sinara-hw/Driver/README.md

# Driver
Semiconductor diode laser current driver

* [RFC](https://github.com/sinara-hw/Driver/issues/1)
* [Wiki](https://github.com/sinara-hw/Driver/wiki)
