sinara-hw/Driver/(list of files, drawings)

Other design files:
AFE_conn.SchDoc
AI_ARTIQ_Driver.SchDoc
connectors.SchDoc
DAC.SchDoc
Diagnostics.SchDoc
FOLLOWER_DIVIDER.SchDoc
HP_LASER_PS.SchDoc
I2C.SchDoc
ISOLATED_PS.SchDoc
LASER_DRIVER_LN_HP.PrjPcb
LN_LASER_PS.SchDoc
output_stage.SchDoc
