sinara-hw/Driver/(threads)

Thread 1 (2019-12-29):

[RFC] Driver: current driver for laser diodes

jordens, 2019-12-29:
We may be looking at designing a diode laser current driver in the future. Comments and secondments welcome.

### General notes

* Low-noise current controller for (low-power) laser diodes.
* Form factor TBD. May end up being a Stabilizer mezzanine or a separate board that interfaces with Stabilizer or a separate EEM
* Either two versions for 200-250mA and 1.5-2A range or variants or one design that fits both
* Different from the [coil current driver](https://github.com/sinara-hw/meta/issues/23) in that it has smaller range, drives diode-like loads, doesn't need that much stability, but needs modulation features.
* Linkage to Thermostat: ethernet, Stabilizer: analog, and Zapper: analog
* Specifications and performance goals similar to the open designs:
  * [Libbrecht-Hall](https://aip.scitation.org/doi/10.1063/1.1143949)
  * [Libbrecht-Hall-Durfree](https://arxiv.org/pdf/0805.0015)
  * [Libbrecht-Hall-Seck](https://arxiv.org/pdf/1604.00374)
  * [JQI](https://github.com/jqiamo/current-controller/tree/v2-updates) to be consolidated, based on Libbrecht-Hall-Durfree
* Compare to proprietary things:
  * [Vescent](https://www.vescent.com/products/electronics/d2-105-laser-controller/)
  * [ILX Lightwave](https://www.newport.com/f/precision-laser-diode-drivers-ldx-3200)
  * [Toptica](https://www.toptica.com/products/tunable-diode-lasers/laser-driving-electronics/)
  * [Koheron](https://www.koheron.com/): uses LT3045, LT3261, OPA567, LT6655
  * [MOGLabs](http://www.moglabs.com/diode-laser-controller.html)
  * [SISYPH SMC11](http://www.sisyph.com/smc11-puy-mary-ultra-low-noise-current-source)

### Variant A

  * 250 mA
  * 2V compliance
  * single quadrant
  * assumptions/requirements w.r.t cathode grounded, anode grounded TBD
  * 0.5 µA resolution, digitally controlled (~100 kHz resolution, 200MHz/mA tuning)
  * 10 kHz small signal bandwidth
  * RMS noise 10Hz-10MHz: 0.3 µA
  * RMS noise 10Hz-10kHz: 0.05 µA
  * Stability (<10Hz) TBD
  * Linearity/absolute accuracy: 2% TBC
  * tempco 5 µA/K (1 MHz/K, 20 ppm/K) TBC
  * high demands on laser diode safety guarantees: no turn on/off transients, no chance of ESD/ground potential difference getting through to the diode, benign behavior and recovery from short circuits and open connections
  * could be some coarse+fine additive or multiplicative hybrid solution to achieve resolution TBD
  * has a modulation/error signal input that is both sampled by an ADC (at 100 kHz) and a high frequency bypass (10 kHz to 100 MHz) that goes onto a bias tee (together with the low frequency current output from the controller) on the output to the laser. Or alternative approaches TBD.

### Variant B (otherwise same as A)
  * 1.5A
  * 3 V compliance
  * bandwidth and resolution much less critical
  * noise requirement at a similar relative level as A

jordens, 2020-01-14:
Added the [AOSense](https://aosense.com/solutions/integrated-laser-controller/) module to the top post. Thanks Mariusz for pointing it out.

dtcallcock, 2020-03-01:
Is there any reason to think Variant B wouldn't also make a nice current supply for the few-Gauss field coils found on most ion traps (or at least a good starting point for one - a factor of 2 more current might be nice)?  Is it funded or was that just the A Variant?

jordens, 2020-03-01:
You'd have to deal with the inductive load. Both variants are funded.
But for shim coils it looks like overkill: around 10 A-turns you can dimension the coil to be in the range of a simple single-opamp voltage-to-current converter running of Zotino/Fastino since there are no grounding restrictions. This would also be bipolar while Driver will not necessarily be.

fimek, 2021-02-08:
Right now there are following problems regarding laser driver:
- combining the expected noise level with reasonable power consumption,
- laser driver precision (meeting the 16-bit DAC precision and resolution),
- bipolar transistors instead of unipolar transistors (due to their more promising noise parameter),
- DAC noise density within 100 kHz bandwidth (seems to be the most challenging - the DAC cannot be BW limited for noise reduction).

It should be decided whether it is sensible to test just the unidirectional current source, or the current source sould be designed as bidirectional (compatible with both common anode and common cathode lasers).

fimek, 2021-02-08:
My strategy briefly explained:
1. DAC: non buffered DAC, where the only output noise is the one generated by the R-2R ladder. Best achievable parameters: 7...9 nV/sqrt(Hz). Proposed ICs: DACx1001, AD5791 (seems similar in performance).
2. DAC output voltage swing: maximum available: 0...10V. If the reference voltage for the current source is too high - can be divided leading to DAC output noise reduction. 0...10V will match the current source optimum driving voltage.....
3. ....which depends on the output transistor emiter resistance. 40 Ohms seems OK, together with ref. voltage of up to 10 V result in 250 mA of maximum laser current.
4. Current source has to be built around the opamp with En <= 3nV/sqrt(Hz), low input current noise (together with DAC ladder resistance would degrade noise performance) <= 0.5 pA/sqrt(Hz), low bias current and appropriate  input voltage offset. Fortunately - such opamps exist: AD8675.
5. By using the additional JFET we can get rid of output transistor base current and maintain DC stability.
6. Power supply: +15V /- 5V (can be +15V/-15 V either).
7. It's a bit tricky to generate a current source with grounded anode/cathode, because the reference voltage for the current source must be referred to Vdd or Vss. I'd rather avoid differential amplifiers (due to remarkable additional noise contribution). I' would use LTC1043 (or similar) instead (the BW is sufficient).
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

Thread 2 (2022-03-21):

Voltage sense

jordens, 2022-03-21:
An independent (from the current driven) measurement of the voltage drop across the diode at the header board ("4-wire") would be very useful.

gkasprow, 2022-03-21:
We have enough analog inputs on the photodiode ADC to do so.

Thread 3 (2022-04-04):

Driver module schematics review

akaminska, 2022-04-04:
Please find attached the preliminary Driver schematics for review. Please note:

- This project is focused on the low-noise current source. The higher power current source is still under design and will be added later.
- The laser protection subsystem ("protection", schematics on the last page of the attached pdf) will be updated, please omit it for now in your review.
[driver_3_en_16032022.pdf](https://github.com/sinara-hw/Driver/files/8410830/driver_3_en_16032022.pdf)

filipswit, 2022-05-18:
PDF version of schematics:
[AI-ARTIQ Driver v0.2.pdf](https://github.com/sinara-hw/Driver/files/8715866/AI-ARTIQ.Driver.v0.2.pdf)

nkrackow, 2022-05-20:
I might have found an issue:
The `TEMP` node is connected to `T11` base for both driver output protection circuits, right? Let's say there is no over-temperature event, so the temperature sensor open drain output can be ignored. Now if the `IC27` flipflop is set for one side, it will drive both `T11` transistors in both output stages in parallel. Or am I missing something?

I know the protection circuit will go to the headboard but the same applies there.

nkrackow, 2022-05-20:
I also did some lengthy staring at the floating DAC ground setup again and while it's still very confusing I convinced myself that this might work..

Also the rest of the relay logic looks good I think. Just that we need to load new outputs into the shift register twice to change the state of K0 with the flipflop. Can't we use a d-latch eg. [this](https://www.ti.com/lit/ds/symlink/sn74lvc1g373.pdf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)? That would also save all of the nand gates since we can just use the inverted state of the node that now goes from K1 to the first nand gate as the enable signal of the latch.

Last thing is that I remember @jordens wanted to maybe sample the voltage over the output current shunt resistor (the one that gives feedback to the opamp). Is that still relevant?

jordens, 2022-05-21:
* The circuitry on protection.SchDoc and I2C_EXPANDER should be on the header board.
* Can we unify CS_OUT_MON and V_LASER_MON? They both appear to have the same functionality (measuring voltage across the load). I don't see the point in having two. Maybe RL2B to switch the measurement channel (Pin 3) between R130 (Pin 2) and the laser (VLASER J2 Pin 1).
* It would be reaslly desirable to get laser diode current monitoring. Maybe we can rejigger the relay circuitry on the header board to achieve that (use a ~1 Ohm shunt for R130 and put that always in series with the sink/source, independent of whether the laser diode is shorted/bypassed). Or other ideas.
* @nkrackow please also thoroughly review the SPI bus usage and assignment w.r.t. how their STM32 peripherals would be used and whether there are interdependencies and constraints.
* The HP source/sink doesn't need to dissipate that much power. It doesn't need to be so low noise. A 0.1 R or even lower shunt should be fine. Also lower supply voltage (to reduce the drop across the power transistor).
* Can we also add NTCs and some simple circuitry to monitor the heatsink temperature using the CPU ADCs?
* How fast is the current sink/source (including all the output circuitry) to the laser diode.
* Can we make use of Stabilizer's ADCs/DACs (J6)? I think one ADC is used for the LF error signal sampling (is that done via SMA separately from the header board?) But there is one more ADC and two DACs. If the current source isn't very fast it may make sense to have at least a way to couple the DACs AC onto the sink/source currents with C jumpers. Just as a DNP option.

jordens, 2022-05-24:
@schiemangk  @j-hirsch you also wanted to have a look.

gkasprow, 2022-05-31:
I moved the protection schematics to the laser module.
I also used an 8k HDMI cable which has individually shielded pairs to transfer all signals from the laser driver to the laser module.
Here are the schematics:
[Laser module PCB.PDF](https://github.com/sinara-hw/Driver/files/8807392/Laser.module.PCB.PDF)
[Frequency REF module PCB.PDF](https://github.com/sinara-hw/Driver/files/8807396/Frequency.REF.module.PCB.PDF)
[Micro_DSUB_IDC.PDF](https://github.com/sinara-hw/Driver/files/8807407/Micro_DSUB_IDC.PDF)

bbradzik, 2022-06-01:
> I might have found an issue: The `TEMP` node is connected to `T11` base for both driver output protection circuits, right? Let's say there is no over-temperature event, so the temperature sensor open drain output can be ignored. Now if the `IC27` flipflop is set for one side, it will drive both `T11` transistors in both output stages in parallel. Or am I missing something?
>
> I know the protection circuit will go to the headboard but the same applies there.

Good point. We will add components to isolate both (LN and HP) TEMP nodes.

bbradzik, 2022-06-01:
> Also the rest of the relay logic looks good I think. Just that we need to load new outputs into the shift register twice to change the state of K0 with the flipflop. Can't we use a d-latch eg. [this](https://www.ti.com/lit/ds/symlink/sn74lvc1g373.pdf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)? That would also save all of the nand gates since we can just use the inverted state of the node that now goes from K1 to the first nand gate as the enable signal of the latch.

About month ago I draw similar circuit with level triggered D flip flop. Greg has told me to swap it with edge triggered D flip flop commenting (as far as i recall) that it will be more proof against unwanted enabling of the laser.

> Last thing is that I remember @jordens wanted to maybe sample the voltage over the output current shunt resistor (the one that gives feedback to the opamp). Is that still relevant?

The idea is good, however it would require to add two instrumentation amplifiers.
Would four voltage measuring points (two per laser diode) be still relevant then?

nkrackow, 2022-06-01:
> About month ago I draw similar circuit with level triggered D flip flop. Greg has told me to swap it with edge triggered D flip flop commenting (as far as i recall) that it will be more proof against unwanted enabling of the laser.

I see, then we'll just do some more flipping and flopping with the CPU via I2C. :)

> The idea is good, however it would require to add two instrumentation amplifiers.
Would four voltage measuring points (two per laser diode) be still relevant then?

Yeah I think this would be on the wishlist from QUARTIQ side. As stated in my response to Roberts points, we could just have the four signals going back to the Stabilizer MCU ADCs (`JADCx_INx_x` on the Stabilizer header, we don't need differential there) via the 8K HDMI cable. I think there should be some lanes available still @gkasprow?

nkrackow, 2022-07-13:
Hi, one more thing that just came up on our side is that the software needs to detect if Driver is present on Stabilizer. A nice way to do this would be to read an EEPROM via the I2C line that goes to Driver anyways. Would be great if we could still tag that onto the prototype.

nkrackow, 2022-07-20:
Ok, one last last thing is that it could be nice to have the global overtemperature node `TEMP` also available on an MCU GPIO if we can fit it somehow.
Sorry, I'll stop adding things here as soon as someone tells me Driver is finalized. ;)

Closed 2022-09-22.

Thread 4 (2022-08-01):

min DP cables

gkasprow, 2022-08-01:
Note to myself and users: mini DP cables have source and sink sides.  Wiki says:
This is the pinout for the source-side connector; the sink-side connector pinout will have lanes 0–3 reversed in order, i.e. lane 3 will be on pin 3(n) and 5(p) while lane 0 will be on pin 10(n) and 12(p).

Thread 5 (2022-08-10):

PDF version

nkrackow, 2022-08-10:
Hi, could we also get a PDF version of the schematic+layout if that's not too much of a hassle?

filipswit, 2022-08-10:
Sorry, I forgot about PDFs
Schematics are in sink variant just to know which other components will be mounted
[AI-ARTIQ Driver v1.0_sch LNsiHPsi.pdf](https://github.com/sinara-hw/Driver/files/9299079/AI-ARTIQ.Driver.v1.0_sch.LNsiHPsi.pdf)
[AI-ARTIQ Driver v1.0_pcb print.pdf](https://github.com/sinara-hw/Driver/files/9299018/AI-ARTIQ.Driver.v1.0_pcb.print.pdf)
[AI-ARTIQ Driver v1.0_3D pcb print.pdf](https://github.com/sinara-hw/Driver/files/9299019/AI-ARTIQ.Driver.v1.0_3D.pcb.print.pdf)

filipswit, 2022-09-19:
[AI-ARTIQ Driver v1.0rc1_sch LNsiHPsi.pdf](https://github.com/sinara-hw/Driver/files/9596875/AI-ARTIQ.Driver.v1.0rc1_sch.LNsiHPsi.pdf)

filipswit, 2022-09-22:
Actual PDFs are in release.

Closed 2022-09-22.

Thread 6 (2022-08-10):

Driver schematic/layout review

nkrackow, 2022-08-10:
We've had a good look at the layout now and it looks very nice! We're of course no experts in layout so we didn't check for clearance or trace thickness or things like that.
Just a few comments about the layout:
- ~~Did you check the assembly with Stabilizer? Aka that there are no tall components potentially colliding with Stabilizers components?~~ Just saw in 3D view of the Altium Viewer that Stabilizer is there, so obviously yes.
- Are the right nodes on the HDMI pins that make connection first? ~~The TEMP node should make connection first when plugging in and break last when pulling out.~~ Edit: The TEMP node should make connection _last_ when plugging in and break _first_ when pulling out.

There are two points from the schematic review still:
- https://github.com/sinara-hw/Driver/issues/3#issuecomment-1190233600 We would really like to also have control over the TEMP node from the CPU. The best would be if the TEMP node is usually pulled low (aka overwriting the relay logic and forcing the laser diode to be shorted) until a CPU pin goes high.
- https://github.com/sinara-hw/Driver/issues/3#issuecomment-1143563047 We would like to measure the voltage across the output shunt resistor to continuously be able to measure the output current.

jordens, 2022-08-10:
> The TEMP node should make connection first when plugging in and break last when pulling out.

The other way round.

filipswit, 2022-08-12:
> https://github.com/sinara-hw/Driver/issues/3#issuecomment-1190233600 We would really like to also have control over the TEMP node from the CPU. The best would be if the TEMP node is usually pulled low (aka overwriting the relay logic and forcing the laser diode to be shorted) until a CPU pin goes high.

So on Driver module, I could use `LPTIM2_OUT`, it's not used so far. Is it fine to just short `TEMP `and `LPTIM2_OUT`?

nkrackow, 2022-08-15:
We would suggest the following solution:

Since we need some kind of decoupling from the transistor bases anyways (https://github.com/sinara-hw/Laser_Module/issues/1), `TEMP` becomes a logic signal that is valid either high or low.
Then we can have a big pulldown resistor (~10K) on `TEMP` the header board that usually makes sure that `K1` cannot be enabled (maybe we don't even need that with npn transistors since nothing is actively driving the node).
The MCU GPIO pin is then connected to `TEMP` via a small resistor (~100 ohm / whatever fits with the base current limiting resistors) and can therefore drive `TEMP` high, making it possible to activate `K1` via the other relay logic.
The LM75 can then still force `TEMP` low.

We could even call this an interlock at this point, but we're fine with naming it `TEMP`, too.

filipswit, 2022-09-19:
The final version is already on repo. I've splitted TEMP and MCU_Interlock, so we have two signals which should be compared on Laser_Module board. I've places them on pins 13 and 19, We can't use  1st pin because it's wired as diff pair so we'd lose it.

jordens, 2022-09-20:
@filipswit Great work. Thanks for the release! Let's hope and push that this gets manufactured in time.
Could you check the issues and either close them when there is nothing to be done or ping the respective people if unresolved and waiting for input?

gkasprow, 2022-09-20:
@filipswit please update the connector as we discussed. I implemented changes on my side
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

filipswit, 2022-09-21:
Updated pinout in https://github.com/sinara-hw/Driver/commit/d203db5ae0c88f6e30ad801b221f2400497f251d

Closed 2022-09-21.

Thread 7 (2022-11-28):

SPI MISO pin driven by both optical isolators concurrently

nkrackow, 2022-11-28:
The SPI MISO pin on the "normal" ground side is actively driven `low`/`high` by both HCPL-092J optical isolators at the same time.
I see good signals (>4.5 V `high`) on the isolated side coming from the DAC but only about 0.5 V `high` signal level on the "normal" GND side. Signals going to the DAC look good too and it's obviously trying to answer.
I'm pretty sure this is because the other isolator chip tries to keep this node low since its isolated side is low because the other DAC isn't selected and therefore it's MISO is low.
I can also see significant ripple with similar frequency content to the SPI traffic on the isolator chip power, which could mean that it's pumping a lot of current.

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

bbradzik, 2022-12-09:
Suggested temporary solution: lift pin 6 of the IC10B.

Thread 8 (2022-12-08):

Floating high power supply 0 V output

nkrackow, 2022-12-08:
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
The way the resistors can be mounted for HP source the `NEG_HP` output is floating. Same for `POS_HP` for a sink. Therefore we have no power on the HP output. Just shorting `R77`/`R73` (or removing them for the next rev) should fix the issue.

Thread 10 (2022-12-09):

(inconclusive) LN DAC reference voltage not stable

nkrackow, 2022-12-09:
The reference voltages of the DAC on the low noise (LN) side seem to be off under some circumstances. Note that all voltages are with respect to DACGND.
If I just power up Driver and don't connect it's output I see +4.1,-5.0 V. The DAC output is also not at the correct value of -5 V, but at around -0.9 V.
If I short the output, I actually see the expected 250 mA (0x00 DAC reset code) on the output and the reference voltages seem to come closer to nominal +- 5 V (actual value: ~4.95, -4.98). The DAC output is now as expected at -5 V aka at the negative reference.
If I set close to 0 output current (max DAC code), I also see relatively good references (~4.95, -4.98) and the expected DAC output of ~4.95 V. The output current is close to 0.

However in the middle, when the DAC outputs ~0 V, the positive reference seems to be off again, showing about 4.8 V.
Note: The HP side reference voltages (with or without R77 shorted) are always very close to ideal at ~ +4.995,-4.995 V.
I didn't yet understand why the reference voltage is off in the middle of the DAC output range and better (also not ideal) at the extremes. Maybe a grounding issue with the DACGND? We couldn't see a problem with it right away but we very well might have missed something.

nkrackow, 2022-12-14:
The HP side references are rock solid under all possible combinations of the following:
- open output
- shorted output
- high output set current
- near-zero output set current
- some other set current

bbradzik, 2022-12-14:
I'm working on communicating with DAC over SPI the crude way (Arduino) to be able to set different codes and reproduce Your problem. I should have some info in few days.

bbradzik, 2022-12-21:
OK, i have SPI working.
For the LN driver I set three values of current: zero, half scale, full scale. Each setting stays for 3s and cycle.
Without load (loaded with 1 ohm) i get RefP5 of 4.999V RefN5 of -4.998V maybe changing by some 1mV while changing codes. DAC output also is close to -5V; 0V; +5V as expected.
Without load (output open) i get RefP5 of 4.999V RefN5 of -4.998V but DAC output is now changing: +4.98V: -0.43V; +2.04V plus IC15B is hot. So probably input diodes of the opamp are conducting and loading the ouptut of the DAC. Nevertheless open output is not a normal condition for a current source.

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

*All voltages measured wrt DACGND.

nkrackow, 2022-12-26:
Yes, I have also noticed that the opamp gets hot when the output is open. Even though it's not the standard operating condition and seems to not brak anything I'd say that's not optimal.

Summing up our voltage readings:
- We see the same voltages/conditions with an open output.
- Wit a loaded output (I simply shorted it) there is a slight difference: I still see slight shifts in the DAC reference voltages of a few 10s of mV while yours is stable to within 1 mV.

I'll check tomorrow how my reference looks like when I connect a small resistor.

nkrackow, 2022-12-28:
I have checked again with two diodes (0.9 - 1.4V drop depending on current) across the output now and this didn't improve things for me. The negative reference is still rock solid but the positive is at:
- 4.935V for close to 0 A aka DAC output close to positive ref.
- 4.830V for 100 mA current aka close to 0V DAC output aka midpoint between pos. and neg. ref.
- 4.875V for 200 mA current aka ~ -3V DAC output

Thread 11 (2022-12-09):

no HP output current HP due to untightened transistor terminals

nkrackow, 2022-12-09:
After shorting R77 according to https://github.com/sinara-hw/Driver/issues/8 I see good rails for the HP output stage.
The DAC also seems to behave as expected under all observed circumstances (output shorted/open, different DAC output setpoints). Unfortunately I never see any current on the output, no matter what current I set. After the follower-divider stage (the purpose of which is not entirely clear to me) I see a small voltage wrt. the positive 9 V rail, but the output opamp (IC15A) is not happy, aka there is a voltage drop across its inputs.
I didn't get any further so far.

bbradzik, 2022-12-14:
_> the follower-divider stage (the purpose of which is not entirely clear to me)_
The important issue with higher current linear current sources is power dissipation. Especially in the sensing resistor. The power is dissipated also in the power transistor and the load but the sensing resistor is a component which determines how stable the output current will be. That is why we don't want to dissipate a lot of heat in it. Considering P=I^2*R we want the resistance to be small. So the voltage across the resistor  will be low. Wee need to create this low voltage for the current source input. This is what the divider is used. We can't just use out 10V from the DAC. We also don't want to load the DAC's ouptut resistive ladder with the resistive divider because we will loose linearity. So the follower is used to prevent DAC's output from being loaded.

jordens, 2022-12-14:
How does this work out quantitatively? The transconductance of the output stage (including its opamp) is 1/R (the resistance of the shunt). The shunt is 0.68 Ohm, the follower has a gain of about 1/40. Hence the overall transconducance is 0.36 A/V and for 10 V max DAC output max output current is 3.6 A. Is that correct?

bbradzik, 2022-12-14:
Very close.
10V*1/41=0.244V
Across 0.068 ohm resistor this gives 3.58A max.

However there is inconsistency: 0.68R resistor value is printed on the schematics while ordered and soldered is 0.067R.
Now the problem with 0.068R is that the lead/wire/contact resistance is comparable.

The initial components were 0.68R and five 10k resistors in the divider (2V full scale output) but at some point it was changed and overlooked.

jordens, 2022-12-14:
Ah. Thanks for clarifying. Let's update schematics then.

bbradzik, 2022-12-14:
Unfortunately some more issues are in the HP driver.
1. both drivers start with the full current after powering up, creating high inrush current. This off course is mostly due to HP driver
2. the power transistor of the HP driver works too close to the envelope of the Safe Operating Area. The effect is more serious when the driver's output is shorted to ground. After connecting laser diode it is getting better. There are two solutions to that: use bigger transistors  (eg. TIP125) or re-calculate the divider so it gives 2.5A max.

SOA chart for presently used transistor is below:
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

jordens, 2022-12-14:
For AI-ARTIQ this isn't a problem yet, as current hasn't been more than 1A.
Stability is also not such a big issue: in steady-state the resistor heating will only lead to a departure from linearity.

nkrackow, 2022-12-14:
The problem was simply that the base and emitter connections of the output transistor were not connected. The leads were just free in the terminals with the screws wide open. Only the collector lead was tightened. Same was true for the LN side but there it happened to make contact without tightening for me. This was the state we received the boards in.

nkrackow, 2022-12-14:
> 10V*1/41=0.244V
Across 0.068 ohm resistor this gives 3.58A max.

The actual current is relatively consistent with this, just about 5% low. This makes sense when taking parasitic resistances of the terminals etc. into account. Those would be an extra 3.5 mΩ then.

bbradzik, 2022-12-14:
> The actual current is relatively consistent with this, just about 5% low. This makes sense when taking parasitic resistances of the terminals etc. into account. Those would be an extra 3.5 mΩ then.
Seems legit.

I'm glad that You found the error. It would be difficult to observe same behaviour on my board.

nkrackow, 2023-06-29:
closing since this was a specific issue with the first Driver

Closed 2023-06-29.

Thread 12 (2022-12-21):

found PCB bugs and errors

bbradzik, 2022-12-21:
1. swapped U_LN and U_HP text on top layer
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

bbradzik, 2022-12-21:
T14A (top) and T14B (bottom) have swapped D and S pins. The error is on the schematics and PCB. A solution is to desolder both transistors (with ESD precautions), flip it and solder on the back (pin 1 stays where it was, pin 2 should be connected to pin 3 of the footprint )

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

nkrackow, 2022-12-28:
Swapping the pins worked nicely for me. The LN side gives relatively accurate current readings now. Unfortunately the scale factor for the HP side is rather impractical and errors in resistance and other factors lead to significant inaccuracy. I'll open a new issue for this.

Thread 13 (2022-12-29):

High Power current sense

nkrackow, 2022-12-29:
The high power side current sense setup is not very accurate because of the combination of the very small current sense resistor (0.068 Ω) and the small translation scale in the opamp. (Using [this](https://github.com/sinara-hw/Driver/issues/12#issuecomment-1362180968) fix)
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
Only a very small part of the ADC range is utilized and the readings are pretty noisy .There is also an offset of about 0.2 A.
The voltage readings of both sides are also somewhat noisy. The following gives a rough idea of the offsets/noise for voltage and current readings:
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
There are current jumps from 0 to 0.2/2.0 A for LN/HP outputs on the left/right over a diode.

bbradzik, 2023-01-04:
Here is a simplified schematic of the present situation in the HP part and the proposed modifications. The four wire Kelvin sensing won't be needed in proposed solution. Please let me know what You think and I will ask Ania to organize parts for me to test it and for You to modify Yours.
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

nkrackow, 2023-02-13:
Hi @bbradzik, sorry for the late reply.
The changes to the sense part look sensible to me. Looking at the current setup it seems like we could also just change the 10K resistor to ~200ohm for now to make better use of the ADC range?
I don't know what the changes in rail and opamp offset voltages entail, so I can't comment on that.

jordens, 2023-02-24:
Would INA194 be a more robust accurate solution for the high side current sense?

Thread 14 (2023-02-16):

Maximum current output when power cycling Driver!

nkrackow, 2023-02-16:
I know we have already noticed this in other contexts but I think this is a potentially a big hazard in the current revision so I'll open this as an extra issue here:
When connecting Driver to power it will try output the maximum current on both LN and HP outputs! After the MCU started up and the DAC initialization code ran, the outputs are set to minimum output current. But for at least a few milliseconds its max output current.
Another nuisance is that a current limiting bench power supply will usually clamp the current and prevent startup since Driver also draws a lot of power during this phase if it can dump the current on its outputs.

Thread 15 (2023-02-16):

Noise/ripple on the Stabilizer MCU ADC inputs

nkrackow, 2023-02-16:
I was wondering why the readings on the current and voltage readbacks are relatively noisy:
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
This is clear for the HP current channel #13, but the voltage readings should be using quite some dynamic range of the ADC.
I first suspected the software/ADC setup procedure since we had problems with this in the past https://github.com/quartiq/stabilizer/issues/571 https://github.com/stm32-rs/stm32h7xx-hal/issues/374

However, I am now quite certain this is actual electrical noise on the nodes.
The samples of the ADC look like this and have about 1000 LSB PP (~1.5% fullscale) and 240 LSB RMS noise.
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

I made a small 50:50 resistor divider between GND and 3V3 directly on the Stabilizer ADC header with the 1.65 connected to an ADC input. Now I see much less noise of ~100 LSB.
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

I cant measure the noise on a multimeter but I can see significant ripple on the scope. Ofc noise is difficult to measure accurately and I just used a standard probe with an alligator GND lead (loop). This is directly on the connector pin that goes to stabilizer:
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
Frequency of the ripple is about 50 kHz. (sorry for the missing x axis)

The LN current measurements look much cleaner too:
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
45 LSB RMS and the pin looks much cleaner on the scope too:
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

Sampling was at 200 Hz with sampling time for one sample 2 ADC cycle times. This means most of the time the ADC was not sampling anything and the noise bandwidth is much higher than the signal bandwidth. Ofc. the 50 kHz ripple are not directly visible on the ADC like this.

The ADC sampling time (in the standard driver code at 810 ADC cycles) has an effect on the noise to about 64 cycles. Longer sampling times don't bring any benefit, at least not with the amount of electrical noise I was seeing anyways.

nkrackow, 2023-02-16:
The problem is that the ADC samples very fast (it could run at 100 kHz of faster) but does so only at a rate of 200 Hz. So I'm not sure what exactly to make of the spectrum:
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
This is the PSD of the data with 1000 LSB PP (~1.5% fullscale) and 240 LSB RMS noise.

nkrackow, 2023-02-16:
Getting the ADC to sample much faster would require quite substantial changes to the software right now..

gkasprow, 2023-02-16:
Can't you just read the ADC as fast as possible filling entire RAM and then dump them to UART?

nkrackow, 2023-02-16:
Well yes but I'd have to write quite some code for that ;)

nkrackow, 2023-02-20:
Could you guys at Creotech (I think @bbradzik has the other Driver right?) check if you see the 50 kHz ripple on the voltage sense nodes? `CS_OUT_MON_LN` and `CS_OUT_MON_HP` on the schematic.

nkrackow, 2023-02-22:
> What amplitude to expect? Under what load and DAC code does it appear?

bbradzik, 2023-02-23:
The P1V5REF voltage is oscillating due to wrong output capacitor selection (red dot shows present situation):

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

Adding 10uF/6.3V X7R MLCC capacitor across C89 on top layer kills the 50kHz oscillations.
However there is still one problem: the P1V5REF rail is still not clean because of the ripple coming from P12V0 power line.
I will prepare the simplest solution to that.

nkrackow, 2023-02-24:
Cool, yeah the voltage readings look a lot better now (jump from 0 to 100 mA over two diodes)
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

Thread 18 (2023-03-21):

Overtemperature condition on Driver leads to more power dissipation instead of less.

nkrackow, 2023-03-21:
Driver features a LM75 temperature sensor that pulls down the `TEMP` node in case of an overtemperature condition. Currently this is only forwarded to the AI-ARTIQ laser module headboard via the HDMI cable where it will trigger relay K1 to short the output to GND.

Unfortunately this only leads to even more power being dissipated in the Driver output stage since the output transistor now has to drop all the voltage to keep the current at the set point. When the output is set to eg. 3 A there will be 40 W dissipated and there is no automatic stopping in HW. The current heatsink can dissipate a fraction of that.

I think In a future revision the HW should be capable of preventing this runaway heating by itself.

nkrackow, 2023-03-21:
Unfortunately I blew my HP output transistor like this...

nkrackow, 2023-03-22:
Also, as a general remark: The current thermal design with the aluminium plate as a heatsink is obviously inadequate for a final design since it also cannot dissipate the necessary power during normal operation (eg. 3 A into a laser diode with 3 V drop would be 30 W on Driver).

nkrackow, 2023-05-24:
I have fixed this on my Driver by simply connecting the Interlock/Temp node to the enable/disable pins of all the power supplies for both the LN and HP side.

Thread 20 (2023-05-02):

Heatsink mounting

nkrackow, 2023-05-02:
The current heatsink solution is not really ideal yet for mounting. The PCB spacers take a lot of force in the horizontal direction and the fins of the heatsink inhibit correct hole placement. Note that the spacers in the back are not connected to the PCB.
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

gkasprow, 2023-05-04:
@jmoskwa did you design this heatsink in CAD or just took a piece of raw extrusion and simply drilled the holes?

filipswit, 2023-05-04:
It's Bartek's heatsink for RnD purpose, since we still don't have final one.

jmoskwa, 2023-05-04:
Yes, I designed it in CAD in the first place. The vertical distance between mounting holes was from th begening 30mm.
Here's the screen from the 3D model. On top the heatsing, beneath - aluminum plate, that was attached to th PCB.
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

gkasprow, 2023-05-09:
Did sb calculate the required thermal resistance?

Thread 21 (2023-06-30):

tabilizer UART header touches big capacitor of Driver

nkrackow, 2023-06-30:
One big capacitor on Driver can potentially touch the UART debug header on Stabilizer. I think the header is installed on all the Stabilizers we have.
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
