sinara-hw/Driver/(commit log)

2022-05-18 Preliminary schematics for LN and HP laser Driver
    [AFE_conn.SchDoc, AI_ARTIQ_Driver.SchDoc, DAC.SchDoc, FOLLOWER_DIVIDER.SchDoc, HP_LASER_PS.SchDoc, I2C_EXPANDER.SchDoc, ISOLATED_PS.SchDoc, LASER_DRIVER_LN_HP.PrjPcb]
2022-05-31 placement in progress
    [AI_ARTIQ_Driver.SchDoc, DAC.SchDoc, FOLLOWER_DIVIDER.SchDoc, ISOLATED_PS.SchDoc, LASER_DRIVER_LN_HP.PrjPcb, LN_LASER_PS.SchDoc, connectors.SchDoc, output_stage.SchDoc]
2022-05-31 removed protection circuit and moved to lased module removed I2c extender circuit and moved to lased module changed net names in DP connector Replaced DP connector with available one Added HDMI conne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
    [AFE_conn.SchDoc, AI_ARTIQ_Driver.SchDoc, Diagnostics.SchDoc, I2C_EXPANDER.SchDoc, LASER_DRIVER_LN_HP.PrjPcb, connectors.SchDoc, protection.SchDoc]
2022-07-29 placement + inital routing
    [AFE_conn.SchDoc, AI_ARTIQ_Driver.SchDoc, DAC.SchDoc, Diagnostics.SchDoc, FOLLOWER_DIVIDER.SchDoc, I2C.SchDoc, I2C_EXPANDER.SchDoc, ISOLATED_PS.SchDoc]
2022-08-09 pcb ready to review
    [LASER_DRIVER_LN_HP.PrjPcb, connectors.SchDoc]
2022-09-21 changed J2 pinout, added transistor to drive led, changed sch revision to v1.0
    [AFE_conn.SchDoc, AI_ARTIQ_Driver.SchDoc, DAC.SchDoc, Diagnostics.SchDoc, FOLLOWER_DIVIDER.SchDoc, HP_LASER_PS.SchDoc, I2C.SchDoc, ISOLATED_PS.SchDoc]
